Faggenza/LoRa-STM32U535-LR1121-HW/LR1121IMLTRT/QFN32_5X5_MLP_SEM.step

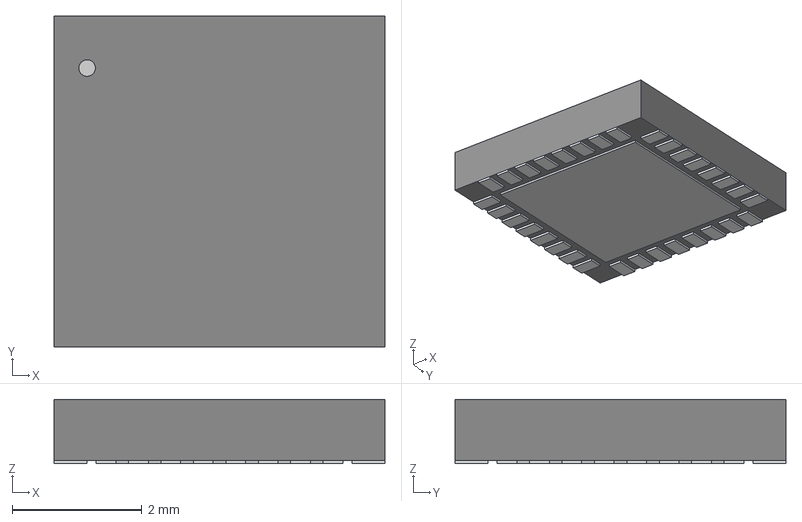
[picture p1: CAD file, 2026-04-17]
LR1121IMLTRT/QFN32_5X5_MLP_SEM.step
5.11 x 5.11 x 0.993 mm
