Faggenza/LoRa-STM32U535-LR1121-HW/SKY13588/QFN12_SKY.stl

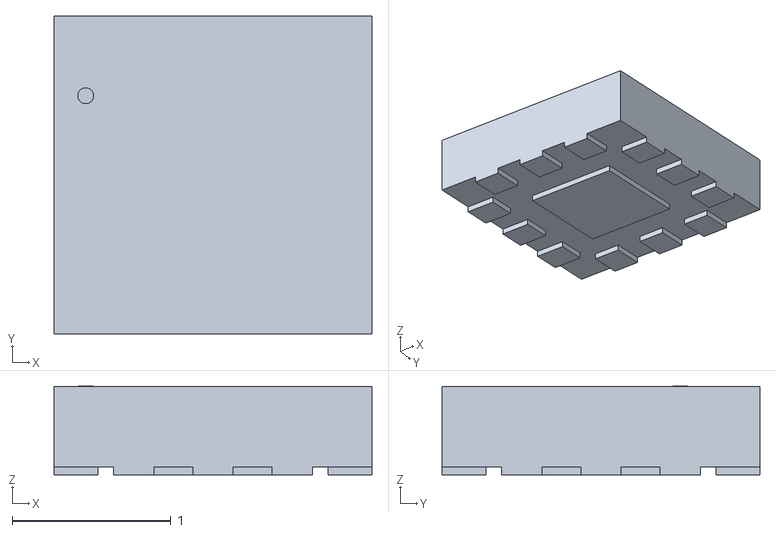
[picture p2: CAD file, 2026-04-24]
SKY13588/QFN12_SKY.stl
2.01 x 2.01 x 0.561
