Faggenza/LoRa-STM32U535-LR1121-HW/STM32U535CBT6Q/LQFP-48.step

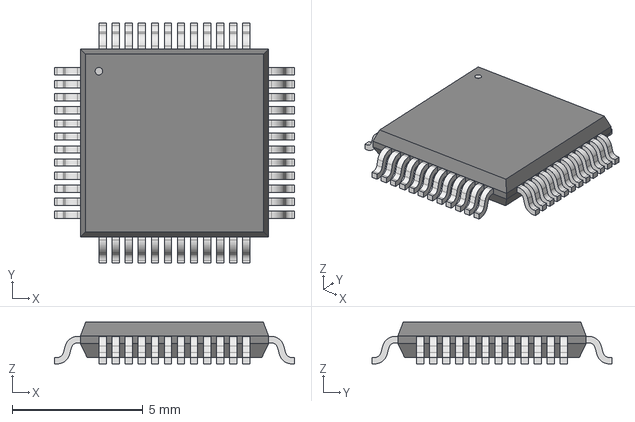
[picture p3: CAD file, 2026-04-17]
STM32U535CBT6Q/LQFP-48.step
9.19 x 9.19 x 1.60 mm
