Faggenza/LoRa-STM32U535-LR1121-HW/lora-stmu535-lr1121-tx.kicad_pcb

## KiCad design lora-stmu535-lr1121-tx.kicad_pcb (2026-05-04)

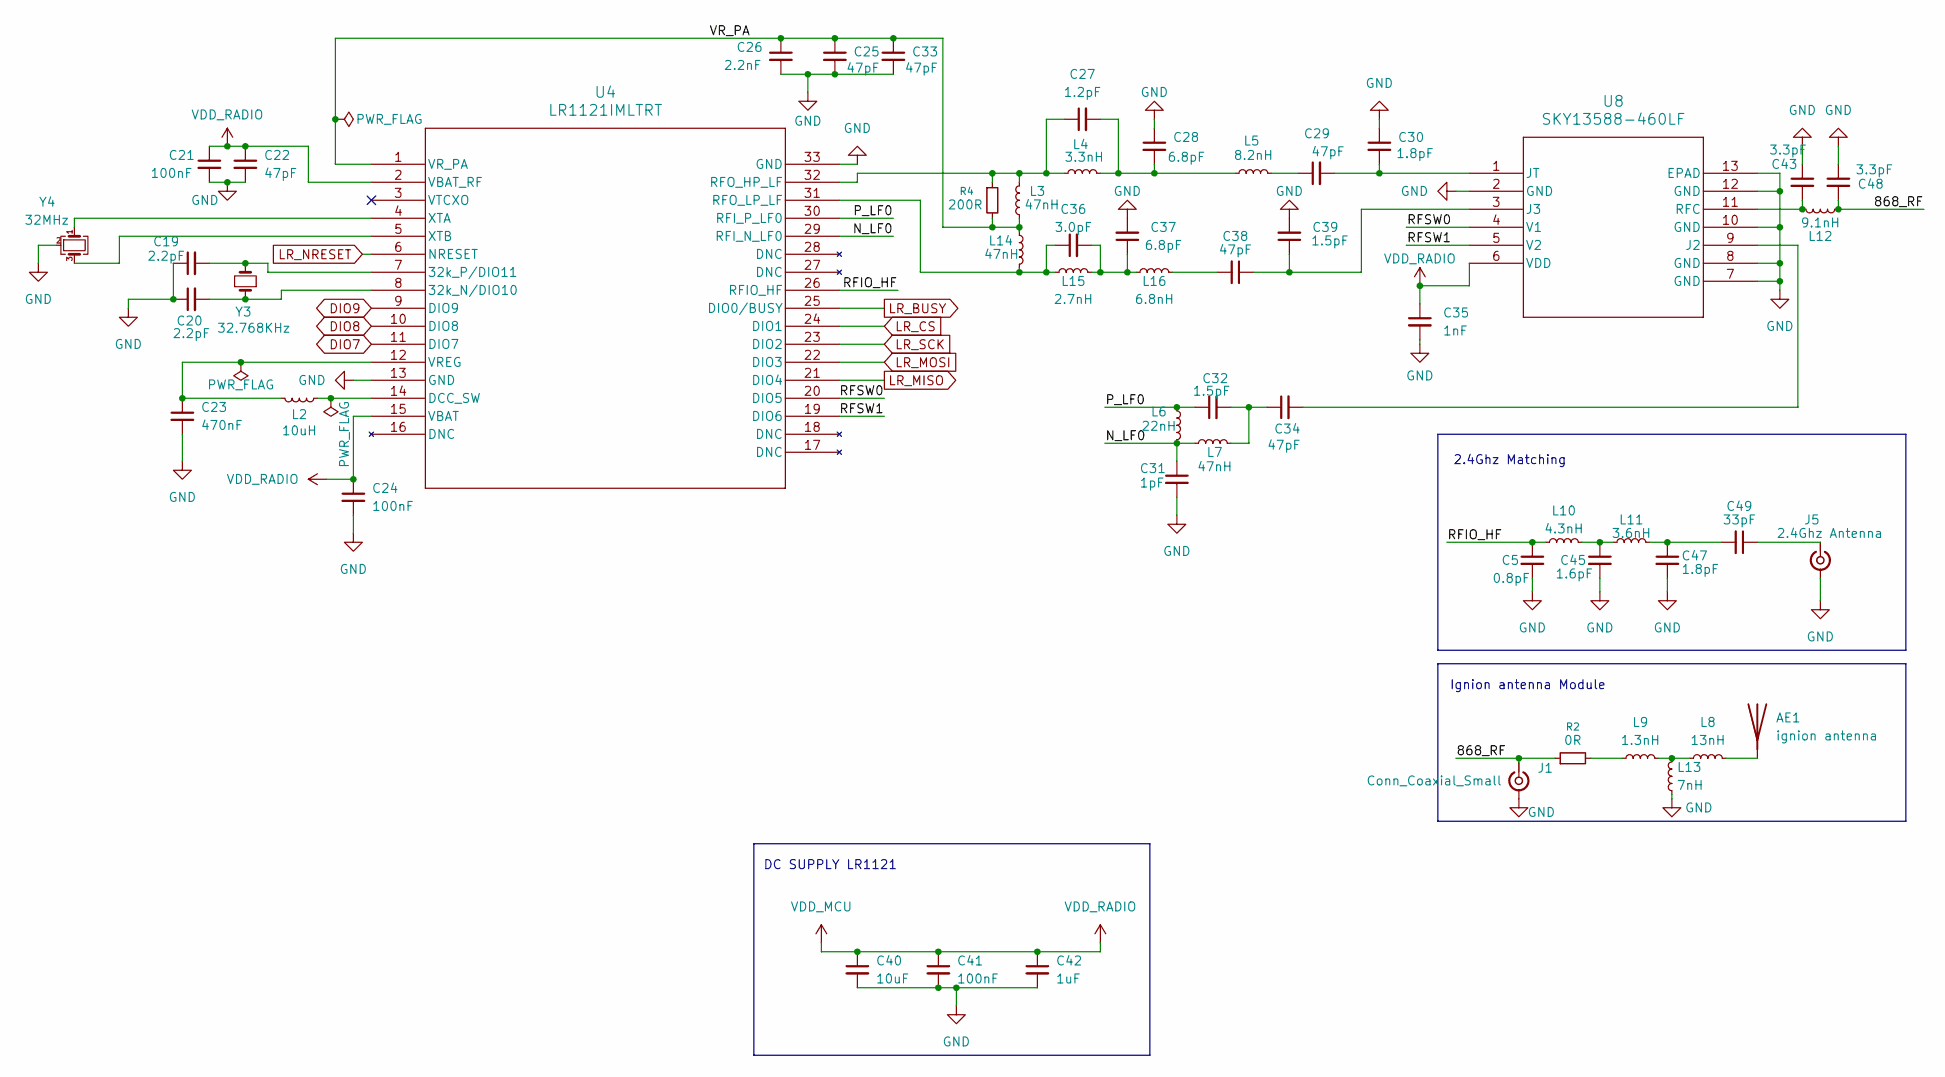
[picture p4: schematic RF.kicad_sch]

Parts:
AE1: ignion antenna; igiion_868
C5: 0.8pF; C_0201_0603Metric
C19, C20: 2.2pF; C_0402_1005Metric_Pad0.74x0.62mm_HandSolder
C21, C24, C41: 100nF; C_0402_1005Metric_Pad0.74x0.62mm_HandSolder
C22: 47pF; C_0402_1005Metric_Pad0.74x0.62mm_HandSolder
C23: 470nF; C_0402_1005Metric_Pad0.74x0.62mm_HandSolder
C25, C29, C33, C34, C38: 47pF; C_0201_0603Metric
C26: 2.2nF; C_0201_0603Metric
C27: 1.2pF; C_0201_0603Metric
C28, C37: 6.8pF; C_0201_0603Metric
C30, C47: 1.8pF; C_0201_0603Metric
C31: 1pF; C_0201_0603Metric
C32, C39: 1.5pF; C_0201_0603Metric
C35: 1nF; C_0201_0603Metric
C36: 3.0pF; C_0201_0603Metric
C40: 10uF; C_0603_1608Metric_Pad1.08x0.95mm_HandSolder
C42: 1uF; C_0402_1005Metric_Pad0.74x0.62mm_HandSolder
C43, C48: 3.3pF; C_0201_0603Metric
C45: 1.6pF; C_0201_0603Metric
C49: 33pF; C_0201_0603Metric
J1: Conn_Coaxial_Small; U.FL_Molex_MCRF_73412-0110_Vertical
J5: 2.4Ghz Antenna; U.FL_Molex_MCRF_73412-0110_Vertical
L2: 10uH; L_0603_1608Metric_Pad1.05x0.95mm_HandSolder
L3, L7, L14: 47nH; L_0201_0603Metric
L4: 3.3nH; L_0201_0603Metric
L5: 8.2nH; L_0201_0603Metric
L6: 22nH; L_0201_0603Metric
L8: 13nH; L_0402_1005Metric_Pad0.77x0.64mm_HandSolder
L9: 1.3nH; L_0402_1005Metric_Pad0.77x0.64mm_HandSolder
L10: 4.3nH; L_0201_0603Metric
L11: 3.6nH; L_0201_0603Metric
L12: 9.1nH; L_0201_0603Metric
L13: 7nH; L_0402_1005Metric_Pad0.77x0.64mm_HandSolder
L15: 2.7nH; L_0201_0603Metric
L16: 6.8nH; L_0201_0603Metric
R2: 0R; R_0603_1608Metric_Pad0.98x0.95mm_HandSolder
R4: 200R; R_0201_0603Metric
U4: LR1121IMLTRT; QFN32_5X5_MLP_SEM
U8: SKY13588-460LF; QFN12_SKY-L
Y3: 32.768KHz; Crystal_SMD_2012-2Pin_2.0x1.2mm_HandSoldering
Y4: 32MHz; Crystal_SMD_2016-4Pin_2.0x1.6mm

Connections:
/RF/868_RF: C48.2, J1.1 (In), L12.2, R2.1
/RF/N_LF0: C31.1, L6.2, L7.1, U4.29 (RFI_N_LF0)
/RF/P_LF0: C32.1, L6.1, U4.30 (RFI_P_LF0)
/RF/RFIO_HF: C5.1, L10.1, U4.26 (RFIO_HF)
/RF/RFSW0: U4.20 (DIO5), U8.4 (V1)
/RF/RFSW1: U4.19 (DIO6), U8.5 (V2)
/RF/VR_PA: C25.1, C26.1, C33.1, L3.1, L14.1, R4.2, U4.1 (VR_PA)
DIO7: U4.11 (DIO7); also elsewhere on the board
DIO8: U4.10 (DIO8); also elsewhere on the board
DIO9: U4.9 (DIO9); also elsewhere on the board
GND: AE1.2, C5.2, C19.1, C20.1, C21.2, C22.2, C23.2, C24.2, C25.2, C26.2, C28.1, C30.1, C31.2, C33.2, C35.2, C37.2, C39.2, C40.2, C41.2, C42.2, C43.1, C45.2, C47.2, C48.1, J1.2 (Ext), J5.2 (Ext), L13.1, U4.13 (GND), U4.33 (GND), U8.2 (GND), U8.7 (GND), U8.8 (GND), U8.10 (GND), U8.12 (GND), U8.13 (EPAD), Y4.2 (G), Y4.4 (G); also elsewhere on the board
LR_BUSY: U4.25 (DIO0/BUSY); also elsewhere on the board
LR_CS: U4.24 (DIO1); also elsewhere on the board
LR_MISO: U4.21 (DIO4); also elsewhere on the board
LR_MOSI: U4.22 (DIO3); also elsewhere on the board
LR_NRESET: U4.6 (NRESET); also elsewhere on the board
LR_SCK: U4.23 (DIO2); also elsewhere on the board
unnamed: C27.2, C28.2, L4.2, L5.1
unnamed: C29.1, L5.2
unnamed: C32.2, C34.1, L7.2
unnamed: C36.2, C37.1, L15.2, L16.1
unnamed: C38.2, L16.2
unnamed: C45.1, L10.2, L11.1
unnamed: C47.1, C49.2, L11.2
unnamed: C49.1, J5.1 (In)
unnamed: L8.1, L9.2, L13.2
unnamed: C20.2, U4.8 (32k_N/DIO10), Y3.1
unnamed: C19.2, U4.7 (32k_P/DIO11), Y3.2
unnamed: L2.1, U4.14 (DCC_SW)
unnamed: C27.1, L3.2, L4.1, R4.1, U4.32 (RFO_HP_LF)
unnamed: C36.1, L14.2, L15.1, U4.31 (RFO_LP_LF)
unnamed: C23.1, L2.2, U4.12 (VREG)
unnamed: U4.4 (XTA), Y4.1
unnamed: U4.5 (XTB), Y4.3
unnamed: C34.2, U8.9 (J2)
unnamed: C38.1, C39.1, U8.3 (J3)
unnamed: C29.2, C30.2, U8.1 (JT)
unnamed: C43.2, L12.1, U8.11 (RFC)
VBAT: C21.1, C22.1, C24.1, C35.1, C40.1, C41.1, C42.1, U4.2 (VBAT_RF), U4.15 (VBAT), U8.6 (VDD); also elsewhere on the board

Notes on the sheet:
2.4Ghz Matching
DC SUPPLY LR1121
Ignion antenna Module

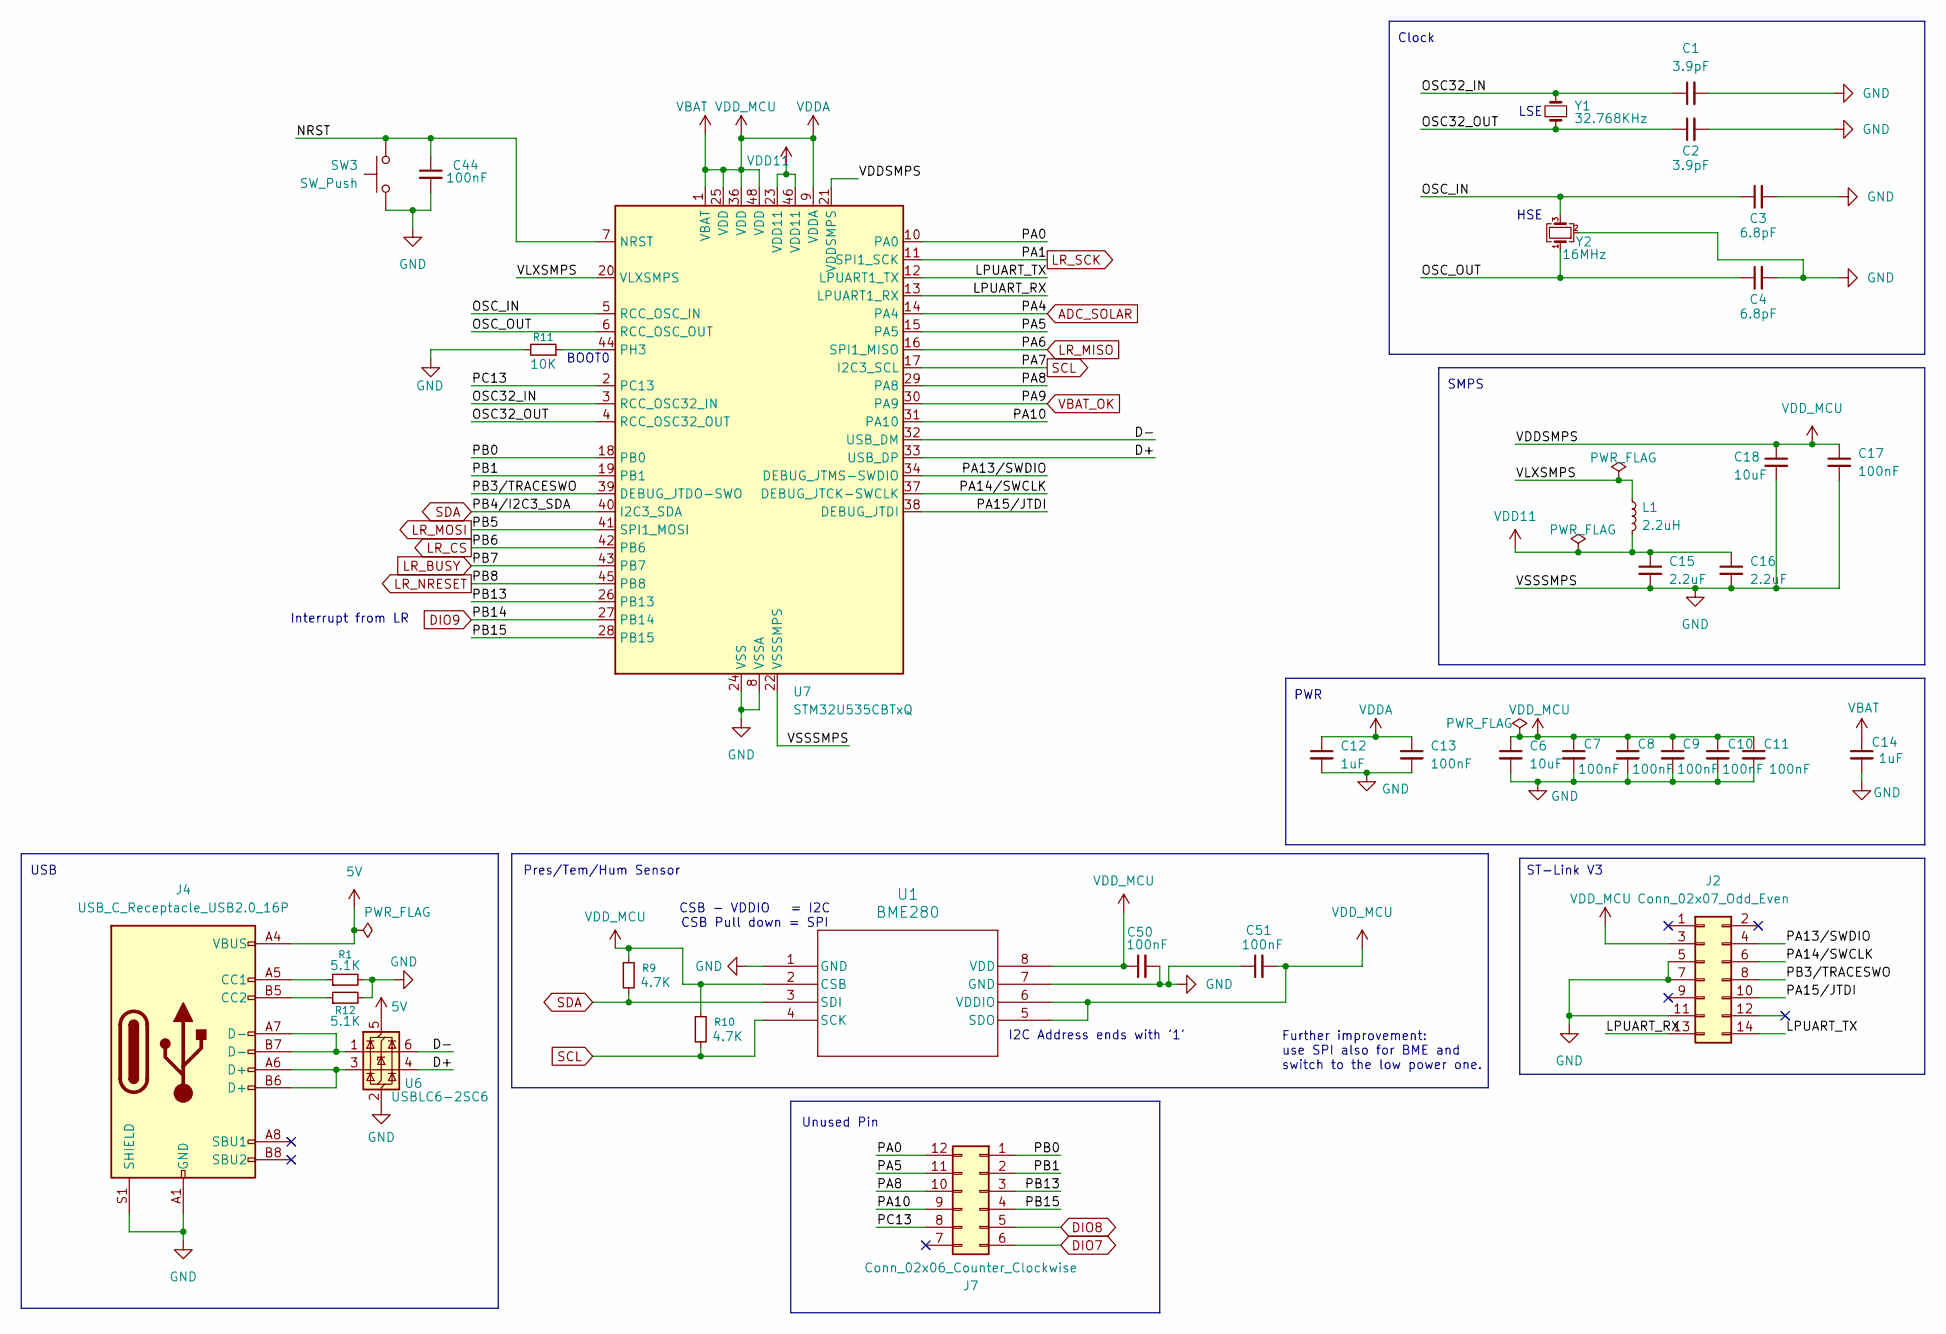
[picture p5: schematic mcu.kicad_sch]

Parts:
C1, C2: 3.9pF; C_0402_1005Metric_Pad0.74x0.62mm_HandSolder
C3, C4: 6.8pF; C_0402_1005Metric_Pad0.74x0.62mm_HandSolder
C6, C18: 10uF; C_0603_1608Metric_Pad1.08x0.95mm_HandSolder
C7, C8, C9, C10, C11, C13, C17, C44, C50, C51: 100nF; C_0402_1005Metric_Pad0.74x0.62mm_HandSolder
C12, C14: 1uF; C_0603_1608Metric_Pad1.08x0.95mm_HandSolder
C15, C16: 2.2uF; C_0603_1608Metric_Pad1.08x0.95mm_HandSolder
J2: Conn_02x07_Odd_Even; PinHeader_2x07_P1.27mm_Vertical_SMD
J4: USB_C_Receptacle_USB2.0_16P; USB_C_Receptacle_G-Switch_GT-USB-7010ASV
J7: Conn_02x06_Counter_Clockwise; PinHeader_2x06_P2.54mm_Vertical
L1: 2.2uH; L_0805_2012Metric_Pad1.05x1.20mm_HandSolder
R1, R12: 5.1K; R_0402_1005Metric_Pad0.72x0.64mm_HandSolder
R9, R10: 4.7K; R_0402_1005Metric_Pad0.72x0.64mm_HandSolder
R11: 10K; R_0402_1005Metric_Pad0.72x0.64mm_HandSolder
SW3: SW_Push; SW_SPST_B3U-1000P
U1: BME280; DFN8_0p65_2p5SQ_BOS
U6: USBLC6-2SC6; SOT-666
U7: STM32U535CBTxQ; LQFP-48_7x7mm_P0.5mm
Y1: 32.768KHz; Crystal_SMD_MicroCrystal_CM9V-T1A-2Pin_1.6x1.0mm_HandSolder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
Y2: 16MHz; Crystal_SMD_2016-4Pin_2.0x1.6mm

Connections:
5V: J4.A4 (VBUS), J4.A9 (VBUS), J4.B4 (VBUS), J4.B9 (VBUS), U6.5 (VBUS); also elsewhere on the board
/MCU/D+: U6.4 (I/O2), U7.33 (USB_DP)
/MCU/D-: U6.6 (I/O1), U7.32 (USB_DM)
/MCU/LPUART_RX: J2.13, U7.13 (LPUART1_RX)
/MCU/LPUART_TX: J2.14, U7.12 (LPUART1_TX)
/MCU/NRST: C44.1, SW3.1, U7.7 (NRST)
/MCU/OSC32_IN: C1.1, U7.3 (RCC_OSC32_IN), Y1.2
/MCU/OSC32_OUT: C2.1, U7.4 (RCC_OSC32_OUT), Y1.1
/MCU/OSC_IN: C3.1, U7.5 (RCC_OSC_IN), Y2.3
/MCU/OSC_OUT: C4.1, U7.6 (RCC_OSC_OUT), Y2.1
/MCU/PA0: J7.12, U7.10 (PA0)
/MCU/PA5: J7.11, U7.15 (PA5)
/MCU/PA8: J7.10, U7.29 (PA8)
/MCU/PA10: J7.9, U7.31 (PA10)
/MCU/PA13/SWDIO: J2.4, U7.34 (DEBUG_JTMS-SWDIO)
/MCU/PA14/SWCLK: J2.6, U7.37 (DEBUG_JTCK-SWCLK)
/MCU/PA15/JTDI: J2.10, U7.38 (DEBUG_JTDI)
/MCU/PB0: J7.1, U7.18 (PB0)
/MCU/PB1: J7.2, U7.19 (PB1)
/MCU/PB3/TRACESWO: J2.8, U7.39 (DEBUG_JTDO-SWO)
/MCU/PB13: J7.3, U7.26 (PB13)
/MCU/PB15: J7.4, U7.28 (PB15)
/MCU/PC13: J7.8, U7.2 (PC13)
/MCU/VLXSMPS: L1.1, U7.20 (VLXSMPS)
ADC_SOLAR: U7.14 (PA4); also elsewhere on the board
DIO7: J7.6; also elsewhere on the board
DIO8: J7.5; also elsewhere on the board
DIO9: U7.27 (PB14); also elsewhere on the board
GND: C1.2, C2.2, C3.2, C4.2, C6.2, C7.2, C8.2, C9.2, C10.2, C11.2, C12.2, C13.2, C14.2, C15.2, C16.2, C17.2, C18.2, C44.2, C50.2, C51.1, J2.5, J2.7, J2.11, J4.A1 (GND), J4.A12 (GND), J4.B1 (GND), J4.B12 (GND), J4.S1 (SHIELD), R1.2, R11.2, R12.2, SW3.2, U1.1 (GND), U1.7 (GND), U6.2 (GND), U7.8 (VSSA), U7.22 (VSSSMPS), U7.24 (VSS), U7.35 (VSS), U7.47 (VSS), Y2.2 (G), Y2.4 (G); also elsewhere on the board
LR_BUSY: U7.43 (PB7); also elsewhere on the board
LR_CS: U7.42 (PB6); also elsewhere on the board
LR_MISO: U7.16 (SPI1_MISO); also elsewhere on the board
LR_MOSI: U7.41 (SPI1_MOSI); also elsewhere on the board
LR_NRESET: U7.45 (PB8); also elsewhere on the board
LR_SCK: U7.11 (SPI1_SCK); also elsewhere on the board
unnamed: J4.A5 (CC1), R1.1
unnamed: J4.B5 (CC2), R12.1
unnamed: J4.A6 (D+), J4.B6 (D+), U6.3 (I/O2)
unnamed: J4.A7 (D-), J4.B7 (D-), U6.1 (I/O1)
unnamed: R11.1, U7.44 (PH3)
SCL: R10.2, U1.4 (SCK), U7.17 (I2C3_SCL)
SDA: R9.2, U1.3 (SDI), U7.40 (I2C3_SDA)
VBAT: C6.1, C7.1, C8.1, C9.1, C10.1, C11.1, C12.1, C13.1, C14.1, C17.1, C18.1, C50.1, C51.2, J2.3, R9.1, R10.1, U1.2 (CSB), U1.5 (SDO), U1.6 (VDDIO), U1.8 (VDD), U7.1 (VBAT), U7.9 (VDDA), U7.21 (VDDSMPS), U7.25 (VDD), U7.36 (VDD), U7.48 (VDD); also elsewhere on the board
VBAT_OK: U7.30 (PA9); also elsewhere on the board
VDD11: C15.1, C16.1, L1.2, U7.23 (VDD11), U7.46 (VDD11)

Notes on the sheet:
Further improvement: use SPI also for BME and switch to the low power one.
BOOT0
I2C Address ends with '1'
Clock
LSE
HSE
SMPS
Interrupt from LR
CSB - VDDIO = I2C CSB Pull down = SPI
ST-Link V3
Pres/Tem/Hum Sensor
PWR
Unused Pin
USB

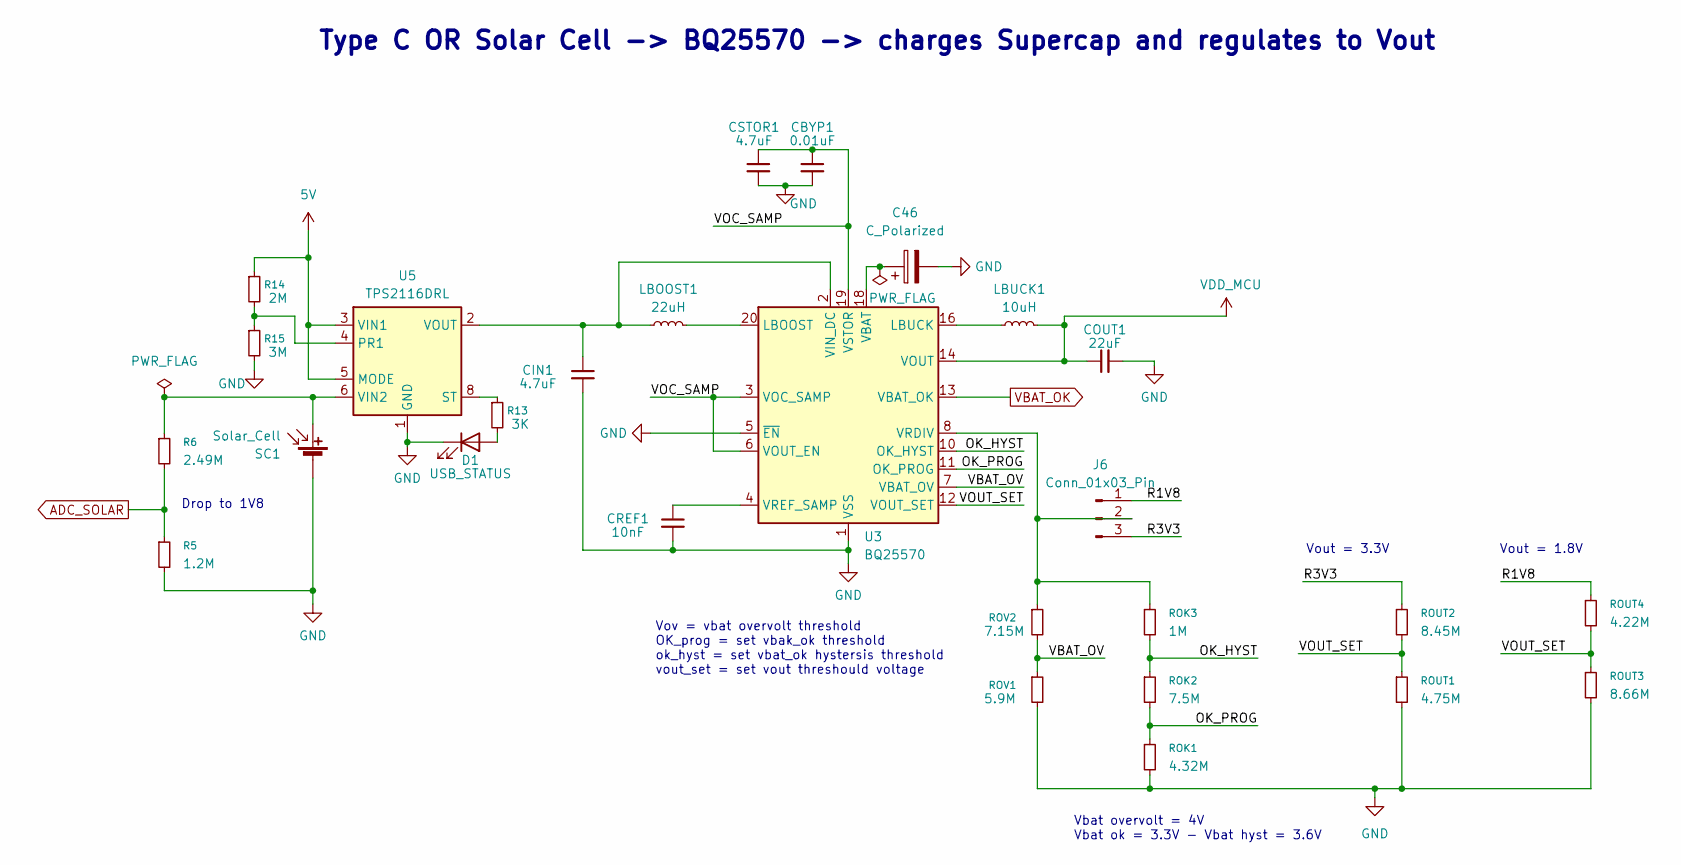
[picture p6: schematic bq25570.kicad_sch]

Parts:
C46: C_Polarized; PinHeader_1x02_P2.54mm_Vertical
CBYP1: 0.01uF; C_0402_1005Metric_Pad0.74x0.62mm_HandSolder
CIN1: 4.7uF; C_0603_1608Metric_Pad1.08x0.95mm_HandSolder
COUT1: 22uF; C_0603_1608Metric_Pad1.08x0.95mm_HandSolder
CREF1: 10nF; C_0402_1005Metric_Pad0.74x0.62mm_HandSolder
CSTOR1: 4.7uF; C_0603_1608Metric_Pad1.08x0.95mm_HandSolder
D1: USB_STATUS; LED_0402_1005Metric_Pad0.77x0.64mm_HandSolder
J6: Conn_01x03_Pin; PinHeader_1x03_P2.54mm_Vertical
LBOOST1: 22uH; L_0402_1005Metric_Pad0.77x0.64mm_HandSolder
LBUCK1: 10uH; L_0603_1608Metric_Pad1.05x0.95mm_HandSolder
R5: 1.2M; R_0402_1005Metric_Pad0.72x0.64mm_HandSolder
R6: 2.49M; R_0402_1005Metric_Pad0.72x0.64mm_HandSolder
R13: 3K; R_0402_1005Metric_Pad0.72x0.64mm_HandSolder
R14: 2M; R_0402_1005Metric_Pad0.72x0.64mm_HandSolder
R15: 3M; R_0402_1005Metric_Pad0.72x0.64mm_HandSolder
ROK1: 4.32M; R_0402_1005Metric_Pad0.72x0.64mm_HandSolder
ROK2: 7.5M; R_0402_1005Metric_Pad0.72x0.64mm_HandSolder
ROK3: 1M; R_0402_1005Metric_Pad0.72x0.64mm_HandSolder
ROUT1: 4.75M; R_0402_1005Metric_Pad0.72x0.64mm_HandSolder
ROUT2: 8.45M; R_0402_1005Metric_Pad0.72x0.64mm_HandSolder
ROUT3: 8.66M; R_0402_1005Metric_Pad0.72x0.64mm_HandSolder
ROUT4: 4.22M; R_0402_1005Metric_Pad0.72x0.64mm_HandSolder
ROV1: 5.9M; R_0402_1005Metric_Pad0.72x0.64mm_HandSolder
ROV2: 7.15M; R_0402_1005Metric_Pad0.72x0.64mm_HandSolder
SC1: Solar_Cell; PinHeader_1x02_P2.54mm_Vertical
U3: BQ25570; QFN-20-1EP_3.5x3.5mm_P0.5mm_EP2x2mm
U5: TPS2116DRL; SOT-583-8

Connections:
5V: R14.1, U5.3 (VIN1), U5.5 (MODE); also elsewhere on the board
/BQ25570/OK_HYST: ROK2.1, ROK3.2, U3.10 (OK_HYST)
/BQ25570/OK_PROG: ROK1.1, ROK2.2, U3.11 (OK_PROG)
/BQ25570/R1V8: J6.1 (1.8), ROUT4.1
/BQ25570/R3V3: J6.3 (3.3), ROUT2.1
/BQ25570/VBAT_OV: ROV1.1, ROV2.2, U3.7 (VBAT_OV)
/BQ25570/VOC_SAMP: CBYP1.1, CSTOR1.1, U3.3 (VOC_SAMP), U3.6 (VOUT_EN), U3.19 (VSTOR)
/BQ25570/VOUT_SET: ROUT1.1, ROUT2.2, ROUT3.1, ROUT4.2, U3.12 (VOUT_SET)
ADC_SOLAR: R5.1, R6.2; also elsewhere on the board
GND: C46.2, CBYP1.2, CIN1.2, COUT1.2, CREF1.2, CSTOR1.2, D1.1 (K), R5.2, R15.2, ROK1.2, ROUT1.2, ROUT3.2, ROV1.2, SC1.2 (-), U3.1 (VSS), U3.5 (~EN), U3.9 (VSS), U3.15 (VSS), U3.17 (VSS), U3.21 (VSS), U5.1 (GND); also elsewhere on the board
unnamed: D1.2 (A), R13.2
unnamed: J6.2, ROK3.1, ROV2.1, U3.8 (VRDIV)
unnamed: R6.1, SC1.1 (+), U5.6 (VIN2)
unnamed: LBOOST1.2, U3.20 (LBOOST)
unnamed: LBUCK1.1, U3.16 (LBUCK)
unnamed: C46.1, U3.18 (VBAT)
unnamed: CIN1.1, LBOOST1.1, U3.2 (VIN_DC), U5.2 (VOUT), U5.7 (VOUT)
unnamed: CREF1.1, U3.4 (VREF_SAMP)
unnamed: R14.2, R15.1, U5.4 (PR1)
unnamed: R13.1, U5.8 (ST)
VBAT: COUT1.1, LBUCK1.2, U3.14 (VOUT); also elsewhere on the board
VBAT_OK: U3.13 (VBAT_OK); also elsewhere on the board

Notes on the sheet:
Vout = 3.3V
Drop to 1V8
Vout = 1.8V
Type C OR Solar Cell -> BQ25570 -> charges Supercap and regulates to Vout
Vbat overvolt = 4V Vbat ok = 3.3V - Vbat hyst = 3.6V
Vov = vbat overvolt threshold OK_prog = set vbak_ok threshold ok_hyst = set vbat_ok hystersis threshold vout_set = set vout threshould voltage

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
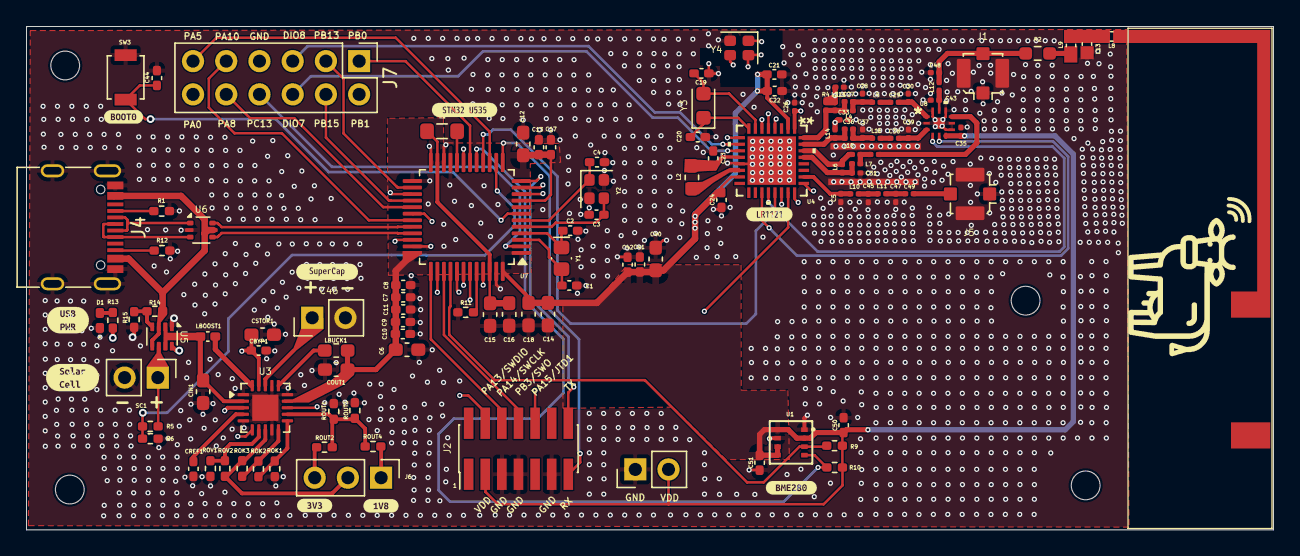
[picture p7: board lora-stmu535-lr1121-tx.kicad_pcb from above]

Board: 4 copper layers, 95.3 x 38.5 mm, 125 parts (0 on the bottom side), 92 nets.

Other parts of the board:
kibuzzard-69E8EEEB: G***; kibuzzard-69E8EEEB
kibuzzard-69E8EEF7: G***; kibuzzard-69E8EEF7
kibuzzard-69E8EF24: G***; kibuzzard-69E8EF24
kibuzzard-69E8EF49: G***; kibuzzard-69E8EF49
kibuzzard-69E8EF58: G***; kibuzzard-69E8EF58
kibuzzard-69E8FA9E: G***; kibuzzard-69E8FA9E
kibuzzard-69EF5185: G***; kibuzzard-69EF5185
kibuzzard-69F35B1F: G***; kibuzzard-69F35B1F
kibuzzard-69F35B2E: G***; kibuzzard-69F35B2E
