Faggenza/LoRa-STM32U535-LR1121-HW/(commit log)

2026-04-17 add device schematic
    [LQFP-48.step, QFN32_5X5_MLP_SEM.step, RF.kicad_sch, bq25570.kicad_sch, lora-stmu535-lr1121-tx.kicad_pcb, lora-stmu535-lr1121-tx.kicad_sch, mcu.kicad_sch]
2026-04-20 footprint assignment
    [RF.kicad_sch, bq25570.kicad_sch, lora-stmu535-lr1121-tx.kicad_pcb, mcu.kicad_sch]
2026-04-22 RF and initial routing
    [RF.kicad_sch, lora-stmu535-lr1121-tx.kicad_pcb, mcu.kicad_sch]
2026-04-22 fix DRC errors and antenna
    [RF.kicad_sch, lora-stmu535-lr1121-tx.kicad_pcb]
2026-04-24 labeling and via placing
    [lora-stmu535-lr1121-tx.kicad_pcb, lora-stmu535-lr1121-tx.kicad_sch]
2026-04-24 changed RF switch in schematics, todo in pcb
    [QFN12_SKY.stl, RF.kicad_sch, lora-stmu535-lr1121-tx.kicad_pcb, mcu.kicad_sch]
2026-04-27 separated matching lines
    [RF.kicad_sch, bq25570.kicad_sch, lora-stmu535-lr1121-tx.kicad_pcb]
2026-04-30 fix smtp line and minor errors
    [RF.kicad_sch, lora-stmu535-lr1121-tx.kicad_pcb, mcu.kicad_sch]
